MissouriMRDT/RamanSpectrometer_Hardware/RamanSpectrometer_Board/Raman BOM.ods

DESIGNATOR | PACKAGE | VALUE | ITEM NAME | MANUFACTURER NUMBER | PART NUMBER | VENDOR | QUANTITY | COST PER ITEM | COST | URL
C1 | Capacitor_SMD:C_0603_1608Metric_Pad1.08x0.95mm_HandSolder | 0.1uF 25V 0603 | Capacitor | CL10B104KA8NNNC | 94AC8890 | Newark | 1 | 0.025 |  | https://www.newark.com/murata/grm033c81e104ke14d/cap-0-1uf-25v-mlcc-0201/dp/94AC8890
C2, C3, C4, C5 | Capacitor_SMD:C_0603_1608Metric_Pad1.08x0.95mm_HandSolder | 10uF 25V 0603 | Capacitor | CL10A106MA8NRNC | 66AJ7194 | Newark | 1 | 0.124 |  | https://www.newark.com/murata/grm188r61e106ka73j/cap-10uf-25v-mlcc-0603-rohs-compliant/dp/66AJ7194
Conn1 | Anderson_3_Horizontal_Side_By_Side | AndersonPP | Anderson Housing |  |  |  | 1
Conn2, Conn4 | MOLEX_SL_05_HORIZONTAL | Molex_SL_05 | SL Connector | 705530004 | 24W9126 | Newark | 2 | 1.68 |  | https://www.newark.com/molex/70553-0004/connector-header-5pos-1row-2-54mm/dp/24W9126
Conn3 | MOLEX_SL_03_HORIZONTAL | Molex_SL_03 | SL Connector | 705530002 | 59H2871 | Newark | 1 | 0.922 |  | https://www.newark.com/molex/70553-0002/connector-header-3pos-1row-2-54mm/dp/59H2871
Conn5 | MOLEX_SL_02_HORIZONTAL | Molex_SL_02 | SL Connector | 705530001 | 59H2870 | Newark | 1 | 0.679 |  | https://www.newark.com/molex/70553-0001/connector-header-2pos-1row-2-54mm/dp/59H2870
D1, D2, D3 | LED_0603_1608Metric_Pad1.05x0.95mm_HandSolder | Green | LED | LTST-C191KGKT | 75K1440 | Newark | 3 | 0.22 |  | https://www.newark.com/lumex/sml-lx0603gw-tr/led-green-0-8mm-x-1mm-18mcd-565nm/dp/75K1440
D4 | LED_0603_1608Metric_Pad1.05x0.95mm_HandSolder | 782nm Laser Diode | Laser Diode |  |  |  | 1
D5 | LED_0603_1608Metric_Pad1.05x0.95mm_HandSolder | 520nm laser diode | Laser Diode |  |  |  | 1
J1 |  | RJ45_LED_Shielded | Ethernet | ETHERNET_KIT | N/A | PJRC | 1 | $3.90 |  | https://www.pjrc.com/store/ethernet_kit.html
Q1, Q2, Q3, Q4, Q5 |  | BSS138 | Mosfet | BSS138BK | 61T7486 | Newark | 5 | 0.374 |  | https://www.newark.com/nexperia/bss138bk/mosfet-n-channel-60v-0-36a-sot23/dp/61T7486
R1 | R_0603_1608Metric_Pad1.05x0.95mm_HandSolder | 2.2k | Resistor | ESR03EZPJ102 | 59AC6943 | Newark | 1 | $0.09 |  | https://www.newark.com/rohm/esr03ezpj102/res-1k-5-0603-thick-film/dp/59AC6943
R2 | R_0603_1608Metric_Pad1.05x0.95mm_HandSolder | 680 | Resistor | CRCW0603300RFKEA | 52K8410 | Newark | 1 | $0.01 |  | https://www.newark.com/vishay/crcw0603300rfkea/res-thick-film-300r-1-0-1w-0603/dp/52K8410
R3 | R_0603_1608Metric_Pad1.05x0.95mm_HandSolder | 330 | Resistor | RMCF0603FT100R |  | Newark | 1
R5, R6 | R_0603_1608Metric_Pad1.05x0.95mm_HandSolder | 4.7k | Resistor | CRCW06034K70FKEA | 61M5388 | Newark | 2 | 0.016 |  | https://www.newark.com/vishay/crcw06034k70fkea/surface-mount-thick-film-resistor/dp/61M5388
R8 | R_0603_1608Metric_Pad1.05x0.95mm_HandSolder | 78.7 | Resistor |  |  |  | 1
R10 | R_0603_1608Metric_Pad1.05x0.95mm_HandSolder | 33 | Resistor |  |  |  | 1
U1 |  | Teensy4.1 | Teensy 4.1 | TEENSY41_PINS | N/A | PJRC | 1 | $35.50 |  | https://www.pjrc.com/store/teensy41_pins.html
U2, U3 | OKI_Horizontal | OKI | Buck Converter |  |  |  | 2
H1, H2, H3, H4 |  |  |  |  |  |  | 4 | 0
--------------------------------------------------------------------------------------------------------------------------------------------------------------------------------------------------------- |  |  |  | ---------------------------------------------------------------------------------------------------------------------------------------- |  |  |  | -------------------------------------------------------------------------------------------- |  |  | -----------------------------------------------------------------------
CCD Breakout
C1 | Capacitor_SMD:C_0603_1608Metric_Pad1.08x0.95mm_HandSolder | 0.01uF 50V 0603 | Capacitor | CL10B103KB8NNNC | 82AC9315 | Newark | 1 | 0.104 |  | https://www.newark.com/samsung-electro-mechanics/cl10b103kb8nnnc/cap-0-01uf-50v-mlcc-0603/dp/82AC9315
C2 | Capacitor_SMD:C_0603_1608Metric_Pad1.08x0.95mm_HandSolder | 22uF 10V 0603 | Capacitor | CL10A226MP8NUNE | 13AM4426 | Newark | 1 | 0.358 |  | https://www.newark.com/samsung-electro-mechanics/cl10a226mp8nune/cap-mlcc-22uf-10v-0603-x5r-rohs/dp/13AM4426
C3 | Capacitor_SMD:C_0603_1608Metric_Pad1.08x0.95mm_HandSolder | 10uF 10V 0603 | Capacitor | C0603C106M8PAC7411 | 82AC9339 | Newark | 1 | 0.27 |  | https://www.newark.com/samsung-electro-mechanics/cl10b106mq8nrnc/cap-10uf-6-3v-mlcc-0603/dp/82AC9339
Conn1 | MOLEX_SL_05_HORIZONTAL | Molex_SL_05 | SL Connector | 705530004 | 24W9126 | Newark | 1 | 1.68 |  | https://www.newark.com/molex/70553-0004/connector-header-5pos-1row-2-54mm/dp/24W9126
Q1 | TO-92 | PNP BJT | MPSA92 | MPSA92 | 08N8078 | Newark | 1 | 0.044 |  | https://www.newark.com/diodes-inc/zxmp3a17e6ta/mosfet-p-channel-30v-4a-sot-23/dp/38K9601?iscrfnonsku=true
R1 | R_0603_1608Metric_Pad1.05x0.95mm_HandSolder | 3k | Resistor | RC0603FR-133KL | 47AK3881 | Newark | 1 | 0.012 |  | https://www.newark.com/multicomp-pro/mpsa92/transistor-pnp-to-92/dp/08N8078
H1, H2, H3, H4 |  |  |  |  |  |  | 4 | 0
U1 |  | ILX511 |  |  |  |  | 1
