MissouriMRDT/RamanSpectrometer_Hardware/CCD_Breakout/CCD_Breakout.kicad_pcb

## KiCad design CCD_Breakout/CCD_Breakout.kicad_pcb (2024-11-15)

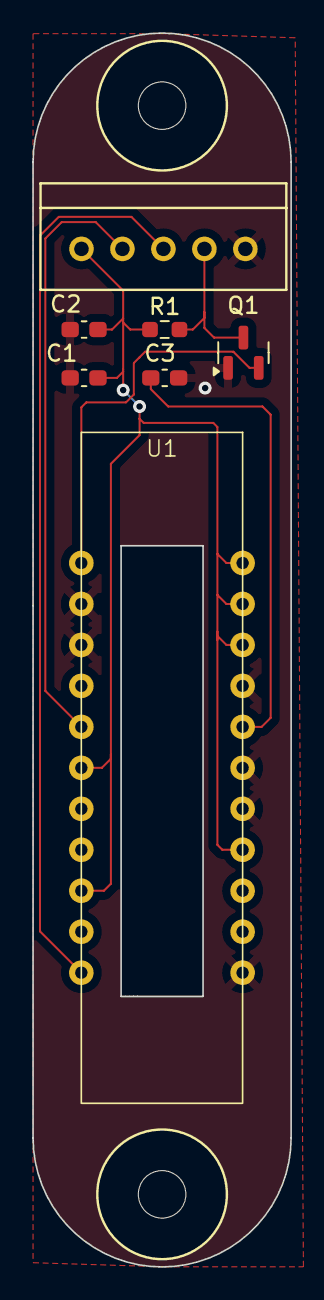
[picture p1: board CCD_Breakout.kicad_pcb from above]

Board: 2 copper layers, 16.0 x 76.5 mm, 9 parts (0 on the bottom side), 7 nets.

Parts:
C1: .01uF; C_0603_1608Metric_Pad1.08x0.95mm_HandSolder
C2: 22uF; C_0603_1608Metric_Pad1.08x0.95mm_HandSolder
C3: 10uF; C_0603_1608Metric_Pad1.08x0.95mm_HandSolder
Conn1: Molex_SL_05; MOLEX_SL_05_Vertical
H1, H2: 4_40_Hole
Q1: PNP; SOT-23
R1: 3k; R_0603_1608Metric_Pad0.98x0.95mm_HandSolder
U1: ILX511

Connections:
+5V: C1.1, C2.1, Conn1.1, R1.1, U1.6 (VDD), U1.9 (VDD), U1.15 (VDD), U1.20 (VDD), U1.21 (VDD), U1.22 (VDD)
CLK: Conn1.2, U1.5 (øCLK)
GND: C1.2, C2.2, C3.1, Conn1.5, Q1.1 (C), U1.2 (GND), U1.3 (GND), U1.12 (GND), U1.16 (GND), U1.17 (GND), U1.19 (GND)
unnamed: Q1.2 (B), U1.1 (Vout)
unnamed: C3.2, U1.18 (VGG)
ROG: Conn1.3, U1.11 (øROG)
Vout: Conn1.4, Q1.3 (E), R1.2
