MissouriMRDT/RamanSpectrometer_Hardware/RamanSpectrometer_Board/RamanSpectrometer_Board.kicad_pcb

## KiCad design RamanSpectrometer_Board/RamanSpectrometer_Board.kicad_pcb (2024-11-13)

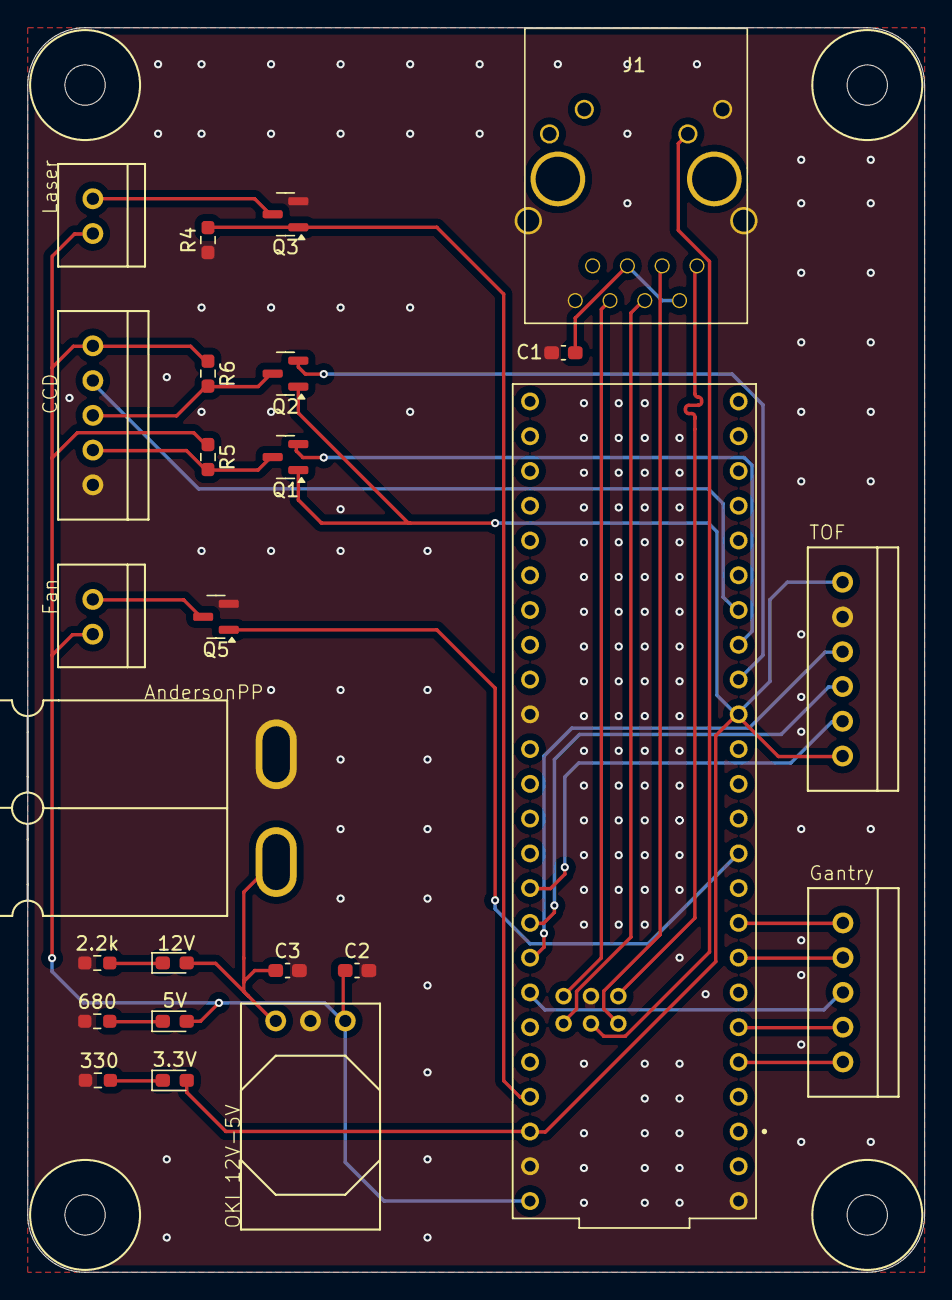
[picture p2: board RamanSpectrometer_Board.kicad_pcb from above]

Board: 2 copper layers, 65.5 x 90.9 mm, 29 parts (0 on the bottom side), 30 nets.

Parts:
C1: 0.1uF; C_0603_1608Metric_Pad1.08x0.95mm_HandSolder
C2, C3: 10uF; C_0603_1608Metric_Pad1.08x0.95mm_HandSolder
Conn1: AndersonPP; Square_Anderson_2_H_Side_By_Side_PV
Conn2: Gantry; MOLEX_SL_05_Vertical
Conn4: CCD; MOLEX_SL_05_Vertical
Conn5: Fan; MOLEX_SL_02_Vertical
Conn6: Laser; MOLEX_SL_02_Vertical
Conn7: TOF Sensor; MOLEX_SL_06_Vertical
D1: 12V; LED_0603_1608Metric_Pad1.05x0.95mm_HandSolder
D2: 5V; LED_0603_1608Metric_Pad1.05x0.95mm_HandSolder
D3: 3.3V; LED_0603_1608Metric_Pad1.05x0.95mm_HandSolder
H1, H2, H3, H4: 4_40_Hole
J1: RJ45_LED_Shielded; RJ45_Teensy
Q1, Q2, Q3, Q5: BSS138; SOT-23
R1: 2.2k; R_0603_1608Metric_Pad0.98x0.95mm_HandSolder
R2: 680; R_0603_1608Metric_Pad0.98x0.95mm_HandSolder
R3: 330; R_0603_1608Metric_Pad0.98x0.95mm_HandSolder
R4, R5, R6: 4.7k; R_0603_1608Metric_Pad0.98x0.95mm_HandSolder
U1: Teensy4.1_DEV-16771; Teensy_4_1_Ethernet
U2: OKI 12V-5V; OKI_Horizontal

Connections:
+3.3V: Conn7.1, Conn7.6, D3.2 (A), Q1.1 (G), Q2.1 (G), U1.3.3V_1 (3.3V), U1.3.3V_2 (3.3V)
+5V: C2.1, Conn4.1, Conn5.2, Conn6.2, D2.2 (A), R5.1, R6.1, U1.VIN, U2.3 (Vo)
+12V: C3.1, Conn1.4 (PV+), D1.2 (A), U2.1 (Vi)
CCD_CLK_5V: Conn4.4, Q1.3 (D), R5.2
CCD_ROG_3.3V: Q2.2 (S), U1.24 (A10)
CCD_ROG_5V: Conn4.3, Q2.3 (D), R6.2
CCD_Vout: Conn4.2, U1.26 (A12)
CLD_CLK_3.3V: Q1.2 (S), U1.25 (A11)
CS: Conn2.3, U1.20 (A6)
FAN_OUT: Q5.1 (G), U1.9 (OUT1C)
GND: C1.2, C2.2, C3.2, Conn1.1 (GND), Conn4.5, Conn7.2, J1.8, J1.9, J1.SH, Q3.2 (S), Q5.2 (S), R1.2, R2.2, R3.2, R4.2, U1.GND1 (GND), U1.GND2 (GND), U1.GND3 (GND), U1.GND5 (GND), U2.2 (GND)
GPIO: Conn7.5, U1.17 (A3)
Green_Laser_3.3V: Q3.1 (G), R4.1, U1.23 (A9)
IN_A: Conn2.4, U1.4 (BCLK2)
IN_B: Conn2.1, U1.7 (RX2)
LED: J1.10, U1.LED
unnamed: C1.1, J1.2, J1.5
unnamed: D1.1 (K), R1.1
unnamed: D2.1 (K), R2.1
unnamed: D3.1 (K), R3.1
unnamed: Conn6.1, Q3.3 (D)
unnamed: Conn5.1, Q5.3 (D)
PWM: Conn2.2, U1.6 (OUT1D)
R+: J1.4, U1.R+
R-: J1.6, U1.R-
SCL: Conn7.3, U1.19 (A5)
SDA: Conn7.4, U1.18 (A4)
SEL: Conn2.5, U1.3 (LRCLK2)
T+: J1.1, U1.T+
T-: J1.3, U1.T-
