MissouriMRDT/RamanSpectrometer_Hardware/Laser Diode Breakout/Laser_Diode_Breakout/Laser_Diode_Breakout.kicad_pcb

## KiCad design Laser Diode Breakout/Laser_Diode_Breakout/Laser_Diode_Breakout.kicad_pcb (2023-10-15)

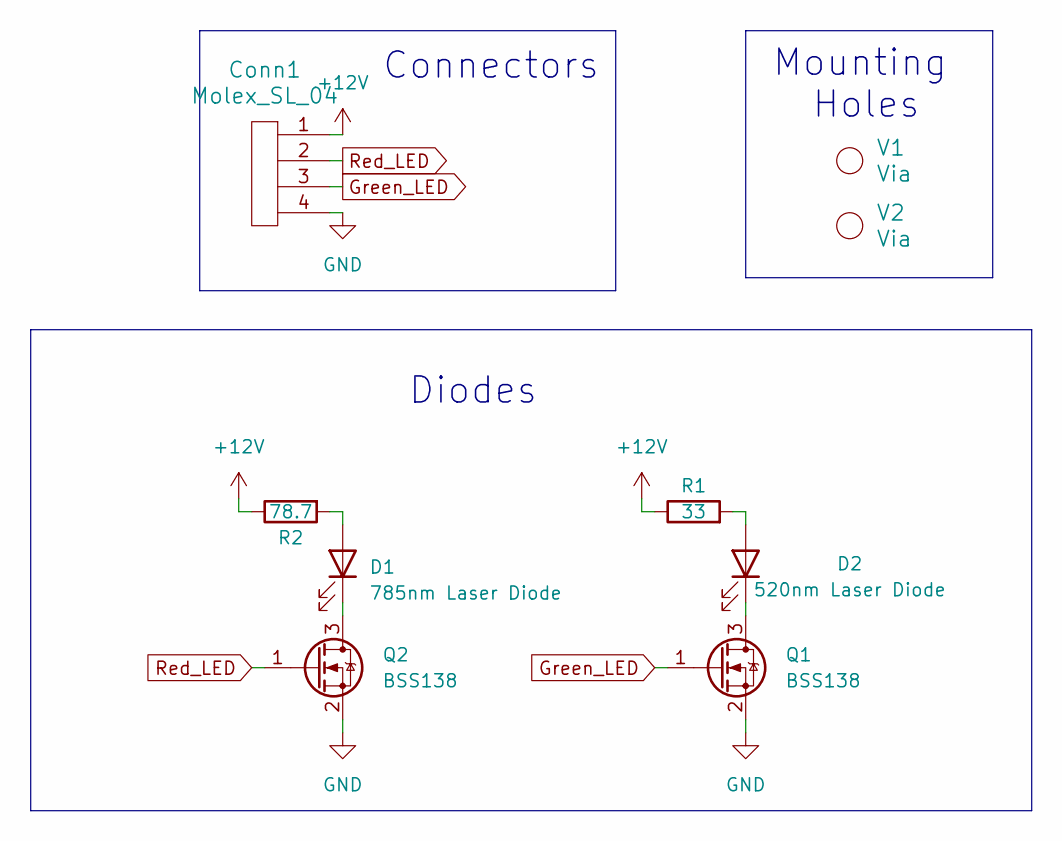
[picture p3: schematic Laser_Diode_Breakout.kicad_sch]

Parts:
Conn1: Molex_SL_04; MOLEX_SL_04_Vertical
D1: 785nm Laser Diode; TO-18-3
D2: 520nm Laser Diode; PLT5520B - 520nm
Q1, Q2: BSS138; SOT-23
R1: 33; R_2512_6332Metric_Pad1.40x3.35mm_HandSolder
R2: 78.7; R_1206_3216Metric_Pad1.30x1.75mm_HandSolder
V1, V2: Via; 4_40_Hole

Connections:
+12V: Conn1.1, R1.1, R2.1
GND: Conn1.4, Q1.2 (S), Q2.2 (S)
Green_LED: Conn1.3, Q1.1 (G)
unnamed: D1.2 (A), R2.2
unnamed: D1.1 (K), Q2.3 (D)
unnamed: D2.2 (A), R1.2
unnamed: D2.1 (K), Q1.3 (D)
Red_LED: Conn1.2, Q2.1 (G)

Notes on the sheet:
Mounting Holes
Connectors
Diodes

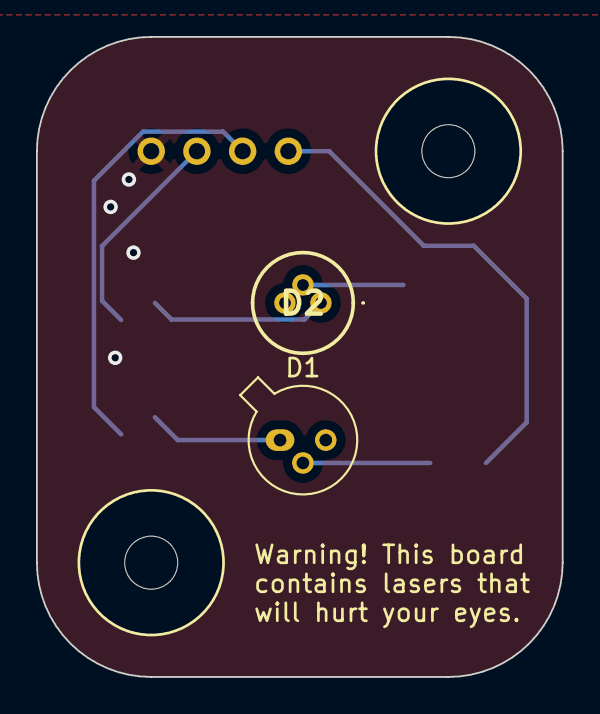
[picture p4: board Laser_Diode_Breakout.kicad_pcb from above]

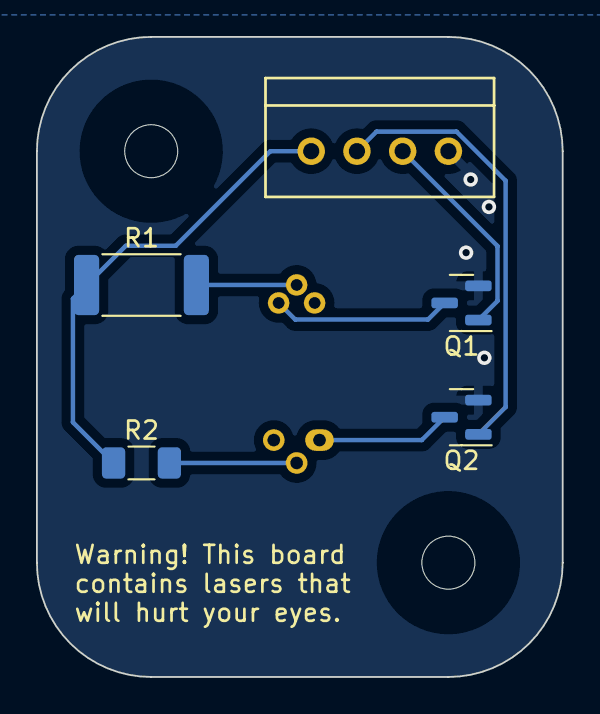
[picture p5: board Laser_Diode_Breakout.kicad_pcb from below]

Board: 2 copper layers, 29.2 x 35.6 mm, 9 parts (5 on the bottom side), 8 nets.
