MissouriMRDT/RamanSpectrometer_Hardware/(commit log)

2023-09-09 chore: created CCD Breakout project
    [CCD_Breakout.kicad_pcb, CCD_Breakout.kicad_sch]
2023-09-09 chore: created empty schematics
    [Laser_Diode_Breakout.kicad_pcb, Laser_Diode_Breakout.kicad_sch, Raman_Spectrometer_Board.kicad_pcb, Raman_Spectrometer_Board.kicad_sch]
2023-09-09 feat: add teensy and ethernet
    [Raman_Spectrometer_Board.kicad_sch]
2023-09-09 Adjust file structure
    [CCD_Breakout.kicad_pcb, CCD_Breakout.kicad_sch, Laser_Diode_Breakout.kicad_pcb, Laser_Diode_Breakout.kicad_sch, Raman_Spectrometer_Board.kicad_pcb, Raman_Spectrometer_Board.kicad_sch]
2023-09-11 feat: created ILX511 symbol for CCD Breakout
    [CCD_Breakout.kicad_sch]
2023-09-12 //WIP CCD Breakout
    [CCD_Breakout.kicad_sch]
2023-09-12 chore: delete duplicate Raman board files
2023-09-15 Finshed CCD breakout
    [CCD_Breakout.kicad_sch, Raman_Spectrometer_Board.kicad_sch]
2023-09-24 Made Laser Diode breakout
    [Laser_Diode_Breakout.kicad_pcb, Laser_Diode_Breakout.kicad_sch]
2023-09-24 added laser breakout to raman board
    [Raman_Spectrometer_Board.kicad_sch]
2023-09-24 finished adding boxes to ramen board
    [Raman_Spectrometer_Board.kicad_sch]
2023-09-24 generated BOM
    [CCD_Breakout.csv, Laser_Diode_Breakout.csv, Laser_Diode_Breakout.kicad_sch, Raman_Spectrometer_Board.csv]
2023-09-24 I forgot to save everything for the last commit
    [Raman_Spectrometer_Board.kicad_sch]
2023-09-24 fix: switched connectors to Molex
    [CCD_Breakout.kicad_sch, Laser_Diode_Breakout.csv, Laser_Diode_Breakout.kicad_sch, Raman_Spectrometer_Board.kicad_sch]
2023-09-25 fix: replaced net labels with text
    [CCD_Breakout.kicad_sch, Laser_Diode_Breakout.kicad_sch, Raman_Spectrometer_Board.kicad_sch]
2023-09-25 misc schematic review changes
    [CCD_Breakout.kicad_sch, Laser_Diode_Breakout.kicad_sch, Raman_Spectrometer_Board.kicad_sch]
2023-09-25 fix: use mosfets to control diodes
    [CCD_Breakout.csv, CCD_Breakout.kicad_sch, Laser_Diode_Breakout.kicad_sch, Raman_Spectrometer_Board.kicad_sch]
2023-09-25 chore: resized Raman Board
    [Raman_Spectrometer_Board.kicad_sch]
2023-09-28 changed AndersonPP to V+ Log
    [Raman_Spectrometer_Board.kicad_sch]
2023-10-02 feat: aligned components for Raman board
    [Raman_Spectrometer_Board.kicad_pcb, Raman_Spectrometer_Board.kicad_sch]
2023-10-03 feat: finish Raman board
    [Raman_Spectrometer_Board.kicad_pcb, Raman_Spectrometer_Board.kicad_sch]
2023-10-03 fix: changes from malacki
    [Raman_Spectrometer_Board.kicad_pcb]
2023-10-13 //WIP working on fixing diodes
    we though one of the diodes required 2V, but that was its reverse voltage. It actually wants 5.9, so we need to change the diode board to account
    [Laser_Diode_Breakout.kicad_sch, Raman_Spectrometer_Board.kicad_sch]
2023-10-14 fixed resitor values on diode board
    [Laser_Diode_Breakout.kicad_sch]
2023-10-14 set footprints for most of laser diode breakout
    [Laser_Diode_Breakout.kicad_sch]
2023-10-14 diode board layout general shape
    [Laser_Diode_Breakout.kicad_pcb, Laser_Diode_Breakout.kicad_sch]
2023-10-14 finished adding footprints to laser diode breakout
    [Laser_Diode_Breakout.kicad_pcb, Laser_Diode_Breakout.kicad_sch]
2023-10-14 added footprints to ccd breakout
    added all capacitors
    the only footprint left is the ccd
    [CCD_Breakout.kicad_sch]
2023-10-14 closed kicad tabs
2023-10-14 finish diode breakout
    [Laser_Diode_Breakout.kicad_pcb]
2023-10-15 created ilx511 footprint
    [CCD_Breakout.kicad_pcb, CCD_Breakout.kicad_sch]
2023-10-15 closed out of kicad tabs
2023-10-15 //WIP start ccd layout
    [CCD_Breakout.kicad_pcb]
2023-10-15 finish ccd
    [CCD_Breakout.kicad_pcb, CCD_Breakout.kicad_sch]
2023-10-15 added ground plane to diode board
    [Laser_Diode_Breakout.kicad_pcb]
2023-10-15 switched raman board to using vertical molex
    [Raman_Spectrometer_Board.kicad_pcb, Raman_Spectrometer_Board.kicad_sch]
2023-10-15 fixed ground plane in diode breakout
    [CCD_Breakout.kicad_pcb, Laser_Diode_Breakout.kicad_pcb]
2023-10-15 rearrange components on raman board
    [Raman_Spectrometer_Board.kicad_pcb]
2023-10-15 added signatures to all boards
    [CCD_Breakout.kicad_pcb, Laser_Diode_Breakout.kicad_pcb, Raman_Spectrometer_Board.kicad_pcb, Raman_Spectrometer_Board.kicad_sch]
2023-10-15 cleaned file structure
    [Laser_Diode_Breakout.csv, Laser_Diode_Breakout.kicad_pcb, Laser_Diode_Breakout.kicad_sch]
2023-10-15 rewired raman board
    [Raman_Spectrometer_Board.kicad_pcb]
2023-10-15 clean up 3V3 wires
    [Raman_Spectrometer_Board.kicad_pcb]
2023-10-15 removed little random traces
    [Raman_Spectrometer_Board.kicad_pcb]
2023-10-15 finished raman board changes
    [Raman_Spectrometer_Board.kicad_pcb]
2023-10-15 added label to raman board
    [Laser_Diode_Breakout.kicad_pcb, Raman_Spectrometer_Board.kicad_pcb]
2023-10-16 finish diode breakout changes
    [Laser_Diode_Breakout.kicad_pcb, Laser_Diode_Breakout.kicad_sch]
2023-10-16 adjusted page sizes for all boards
    [CCD_Breakout.kicad_pcb, Laser_Diode_Breakout.kicad_pcb, Raman_Spectrometer_Board.kicad_pcb]
2023-10-16 finish ccd board
    [CCD_Breakout.kicad_pcb, CCD_Breakout.kicad_sch]
2023-10-16 adjust silkscreen on diode board
    [Laser_Diode_Breakout.kicad_pcb]
2023-10-16 adjust silkscreen for raman board
    [Raman_Spectrometer_Board.kicad_pcb]
2023-10-16 removed small random traces
    [CCD_Breakout.kicad_pcb]
2023-10-19 fixed board name silkscreens
    [CCD_Breakout.kicad_pcb, Laser_Diode_Breakout.kicad_pcb, Raman_Spectrometer_Board.kicad_pcb]
2023-10-21 generated step files
    [CCD_Breakout.step, Laser_Diode_Breakout.step, Raman_Spectrometer_Board.step]
2023-10-21 closed kicad
2023-10-21 add 4.7k resistor to mosfets and regenerate BOM
    [CCD_Breakout.csv, Laser_Diode_Breakout.csv, Laser_Diode_Breakout.kicad_pcb, Laser_Diode_Breakout.kicad_sch, Raman_Spectrometer_Board.csv, Raman_Spectrometer_Board.kicad_pcb, Raman_Spectrometer_Board.kicad_sch]
2023-10-21 changes for layout review #2
    [CCD_Breakout.kicad_pcb, Laser_Diode_Breakout.kicad_pcb, Raman_Spectrometer_Board.kicad_pcb]
2023-10-31 generated GERBS
    [CCD_Breakout-B_Cu.gbr, CCD_Breakout-B_Mask.gbr, CCD_Breakout-B_Paste.gbr, CCD_Breakout-B_Silkscreen.gbr, CCD_Breakout-Edge_Cuts.gbr, CCD_Breakout-F_Cu.gbr, CCD_Breakout-F_Mask.gbr, CCD_Breakout-F_Paste.gbr]
2023-10-31 fix differential pairs and center LEDs on diode board
    [Laser_Diode_Breakout.kicad_pcb, Raman_Spectrometer_Board.kicad_pcb]
2023-10-31 regenerate GERBS
    [Laser_Diode_Breakout-B_Cu.gbr, Laser_Diode_Breakout-B_Mask.gbr, Laser_Diode_Breakout-B_Paste.gbr, Laser_Diode_Breakout-B_Silkscreen.gbr, Laser_Diode_Breakout-Edge_Cuts.gbr, Laser_Diode_Breakout-F_Cu.gbr, Laser_Diode_Breakout-F_Mask.gbr, Laser_Diode_Breakout-F_Paste.gbr]
2023-11-03 changes from layout review #3
    [CCD_Breakout-B_Cu.gbr, CCD_Breakout-B_Mask.gbr, CCD_Breakout-B_Paste.gbr, CCD_Breakout-B_Silkscreen.gbr, CCD_Breakout-Edge_Cuts.gbr, CCD_Breakout-F_Cu.gbr, CCD_Breakout-F_Mask.gbr, CCD_Breakout-F_Paste.gbr]
2024-09-26 Reset branch
    [CCD_Breakout-B_Cu.gbr, CCD_Breakout-B_Mask.gbr, CCD_Breakout-B_Paste.gbr, CCD_Breakout-B_Silkscreen.gbr, CCD_Breakout-Edge_Cuts.gbr, CCD_Breakout-F_Cu.gbr, CCD_Breakout-F_Mask.gbr, CCD_Breakout-F_Paste.gbr]
2024-10-03 fix
    fixed from 2024rev1 push
    [RamanSpectrometer_Board.kicad_sch]
2024-10-04 Added CCD Breakout
    [RamanSpectrometer_Board.kicad_sch]
2024-10-04 Mounting Holes / Formatting
    [RamanSpectrometer_Board.kicad_sch]
2024-10-04 Finished Raman Spectrometer Schematic. Merged Diode Breakout onto the board, but also left a connector in case we use a store-bought diode/external one off the board. Might want to check over the sch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
    [RamanSpectrometer_Board.kicad_sch]
2024-10-04 Changed Labels
    [RamanSpectrometer_Board.kicad_sch]
2024-10-05 Gantry and fan connector pins
    [Raman BOM.ods]
2024-10-05 Started on BOM. Updated gantry and fan connectors
    [Raman BOM.ods, RamanSpectrometer_Board.kicad_sch]
2024-10-06 Updated BOM a little bit
    [Raman BOM.ods]
2024-10-10 Raman Schematic Review
    Made changes to the labels on the gantry connector and teensy.
    [RamanSpectrometer_Board.kicad_sch]
2024-10-11 Added Mounting Holes
    [CCD_Breakout.kicad_sch]
2024-10-11 CCD GND
    [CCD_Breakout.kicad_sch]
2024-10-17 updated schematic
    [CCD_Breakout.kicad_sch, RamanSpectrometer_Board.kicad_sch]
2024-10-17 Updated Bill of Materials
    [Raman BOM.ods]
2024-10-17 updated BOM again
    [Raman BOM.ods]
2024-10-24 pcb layout
    [RamanSpectrometer_Board.kicad_pcb]
2024-10-25 PCB Holes
    [RamanSpectrometer_Board.kicad_pcb, RamanSpectrometer_Board.kicad_sch]
2024-10-26 pcb routing
    [RamanSpectrometer_Board.kicad_pcb, RamanSpectrometer_Board.kicad_sch]
2024-10-27 PCB rough draft
    [RamanSpectrometer_Board.kicad_pcb, RamanSpectrometer_Board.kicad_sch]
2024-10-28 PCB revision
    [RamanSpectrometer_Board.kicad_pcb]
2024-10-30 PCB Draft 2
    [RamanSpectrometer_Board.kicad_pcb]
2024-10-30 Started on CCD
    [CCD_Breakout.kicad_pcb, CCD_Breakout.kicad_sch, RamanSpectrometer_Board.kicad_pcb]
2024-10-30 Raman PCB redesign
    [RamanSpectrometer_Board.kicad_pcb]
2024-10-30 Raman PCB revisions
    [RamanSpectrometer_Board.kicad_pcb]
2024-10-31 PCB Raman updates
    [RamanSpectrometer_Board.kicad_pcb]
2024-10-31 PCB Raman again
    [RamanSpectrometer_Board.kicad_pcb]
2024-11-05 PCB Raman 12V Plane
    [RamanSpectrometer_Board.kicad_pcb]
2024-11-05 PCB Raman edit and TOF
    [RamanSpectrometer_Board.kicad_pcb, RamanSpectrometer_Board.kicad_sch]
2024-11-07 Raman PCB Additions
    [RamanSpectrometer_Board.kicad_pcb, RamanSpectrometer_Board.kicad_sch]
2024-11-07 Raman PCB Final
    [RamanSpectrometer_Board.kicad_pcb]
2024-11-07 Updated CCD
    [CCD_Breakout.kicad_pcb, CCD_Breakout.kicad_sch]
2024-11-07 Schematic Changes
    [RamanSpectrometer_Board.kicad_sch]
2024-11-11 CCD Changes
    [CCD_Breakout.kicad_pcb, CCD_Breakout.kicad_sch]
2024-11-12 Raman PCB board review pt.1
    [RamanSpectrometer_Board.kicad_pcb, RamanSpectrometer_Board.kicad_sch]
2024-11-12 Raman pt.2
    [RamanSpectrometer_Board.kicad_pcb, RamanSpectrometer_Board.kicad_sch]
2024-11-12 Raman pt.3 (RIP Comic Sans)
    [RamanSpectrometer_Board.kicad_pcb]
2024-11-13 Raman dimension changes
    [RamanSpectrometer_Board.kicad_pcb]
2024-11-13 Raman dimensions fixed
    [RamanSpectrometer_Board.kicad_pcb]
